craigyjp/Dual-VCDCO-monosynth/Schematics/Control_circuits.pdf

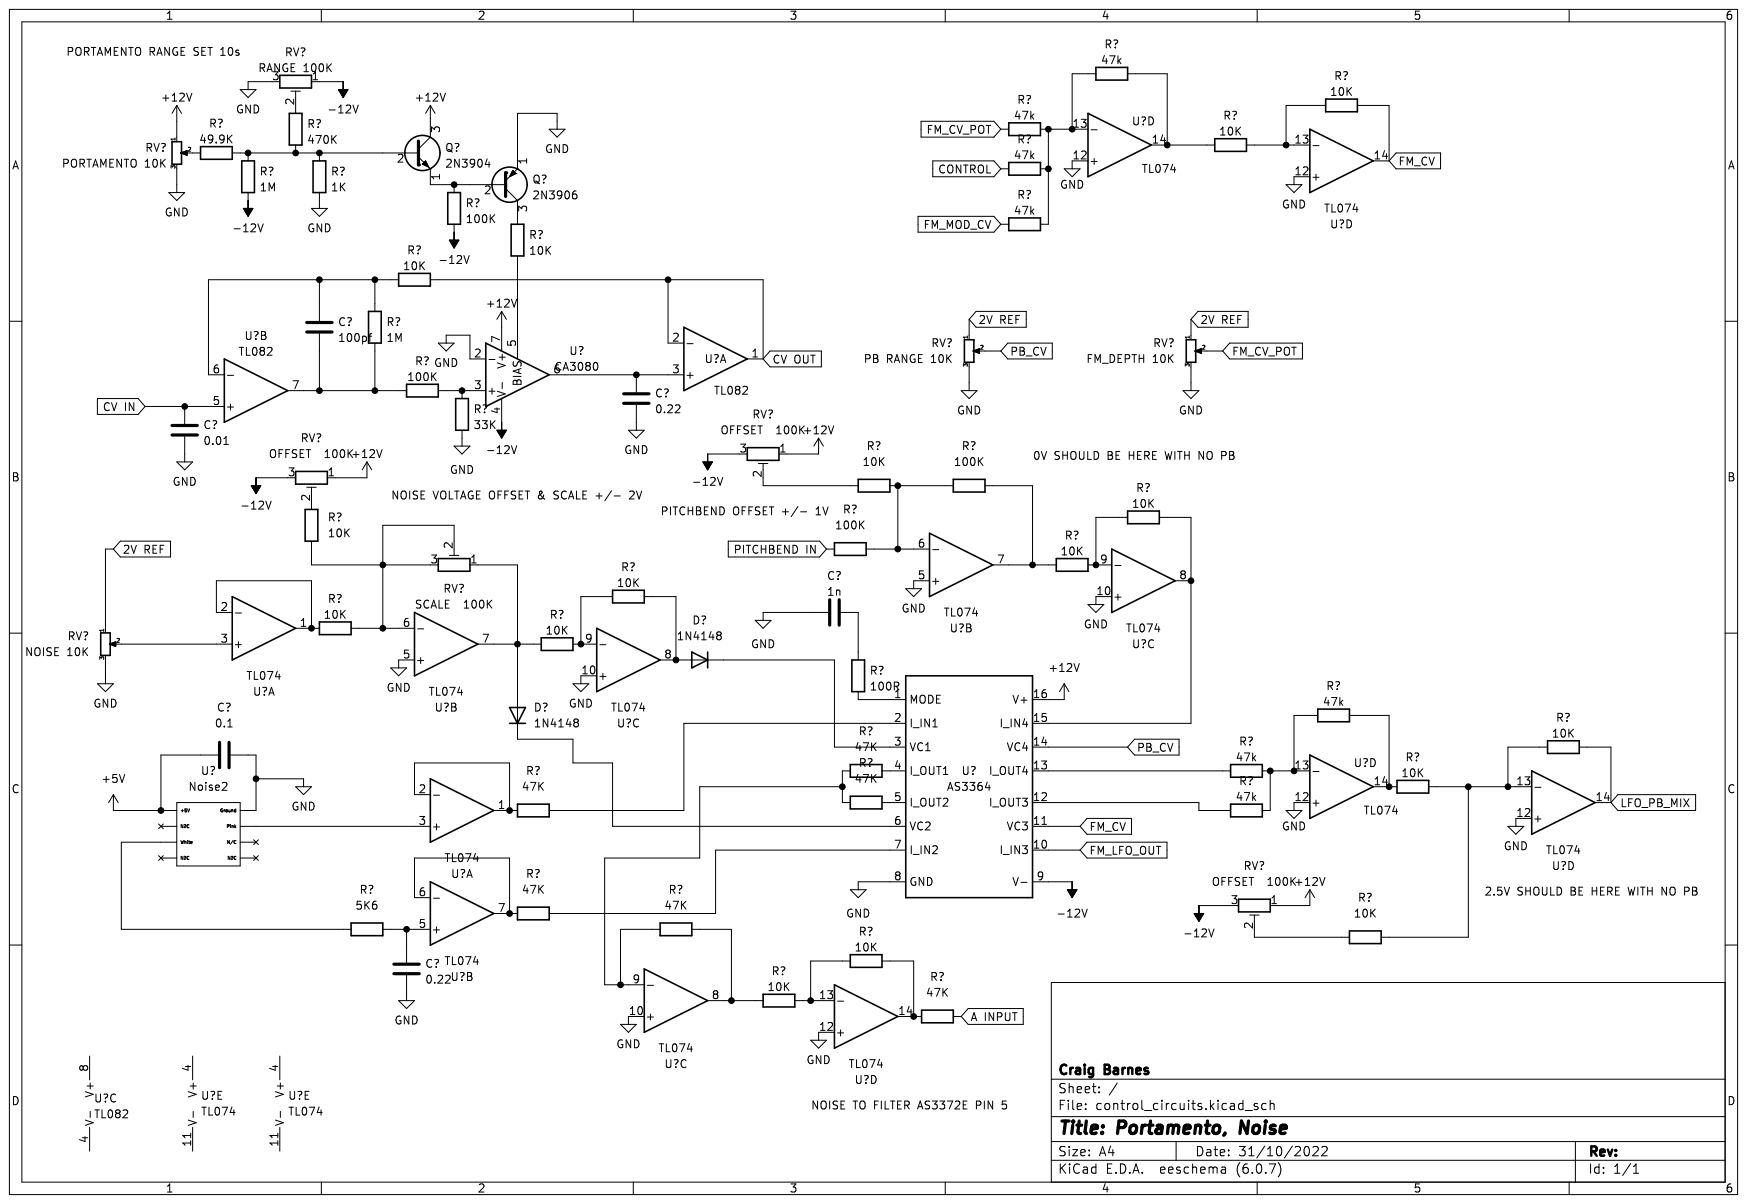
[picture p1: page 1]
