craigyjp/Dual-VCDCO-monosynth/Schematics/EnvGen8C.pdf

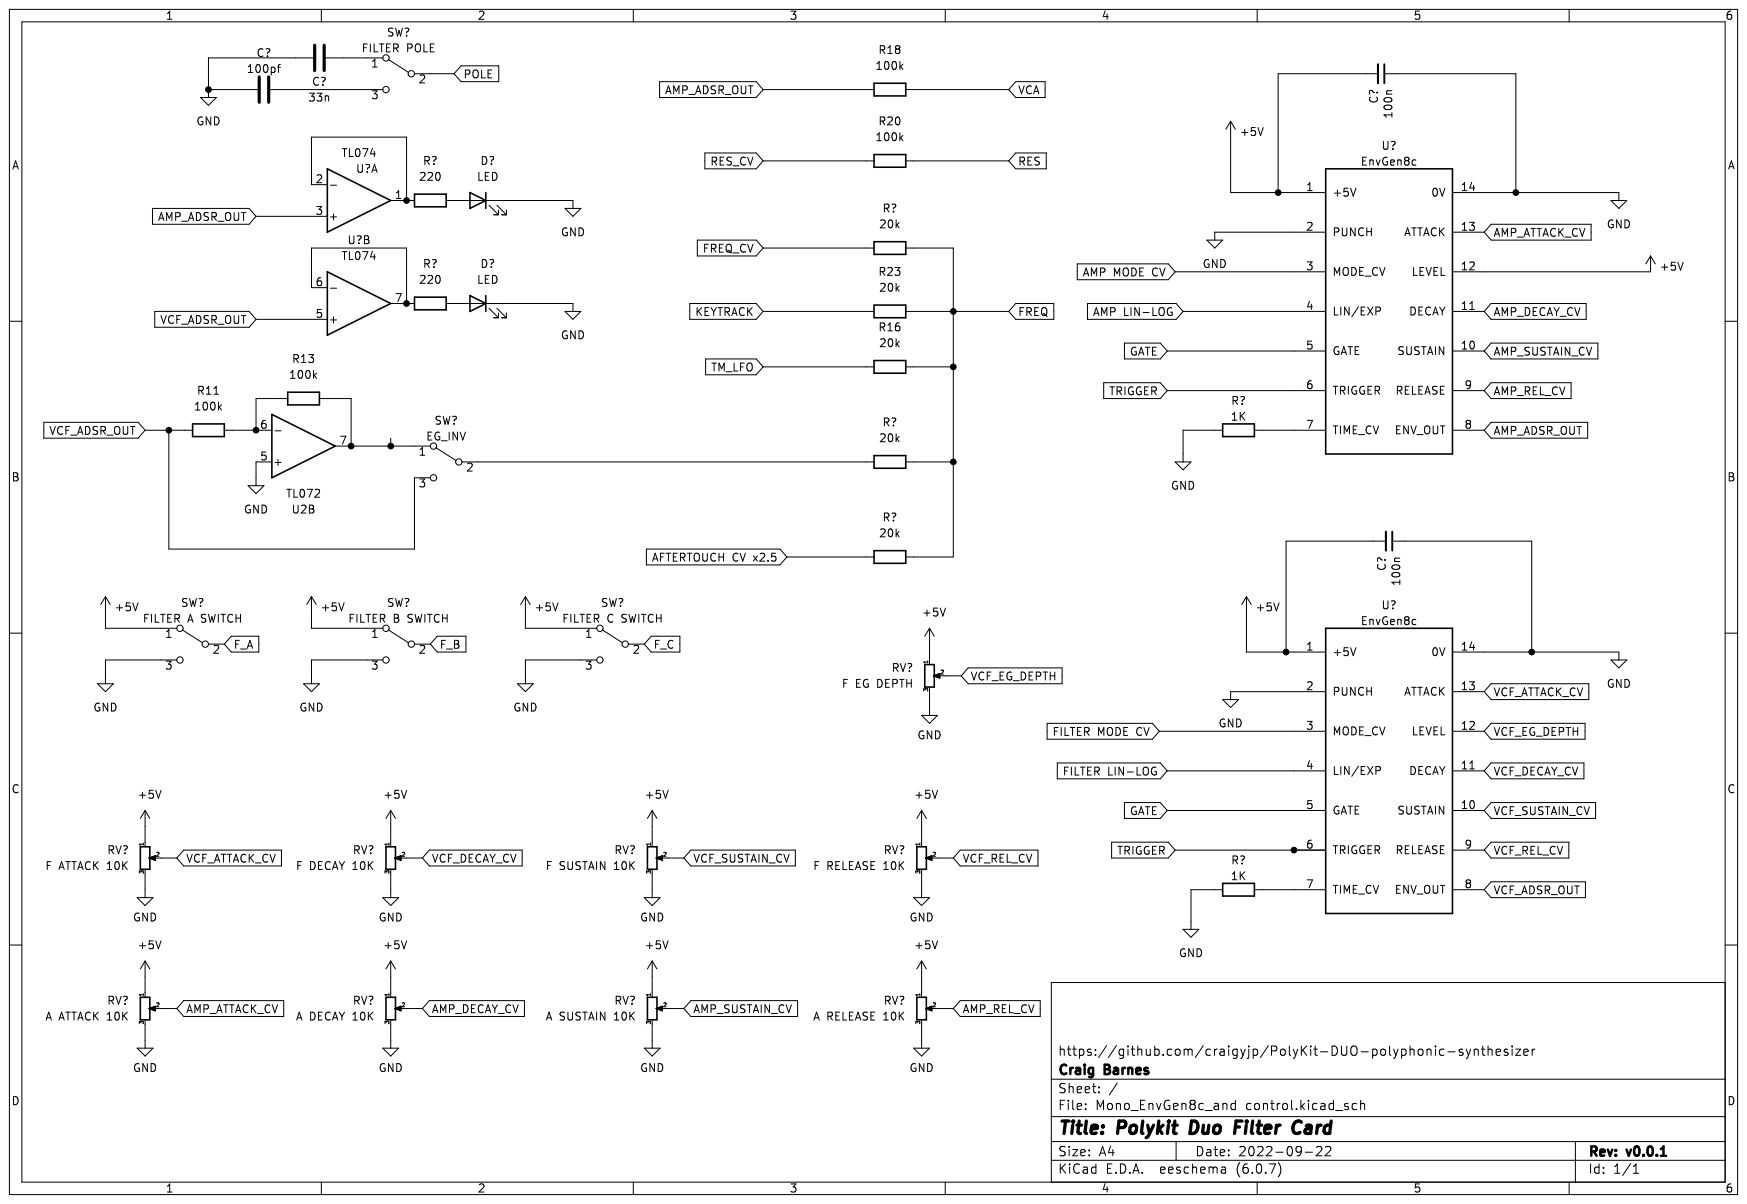
[picture p2: page 1]
