craigyjp/Dual-VCDCO-monosynth/Schematics/MIDI_to_CV_Channel_change.pdf

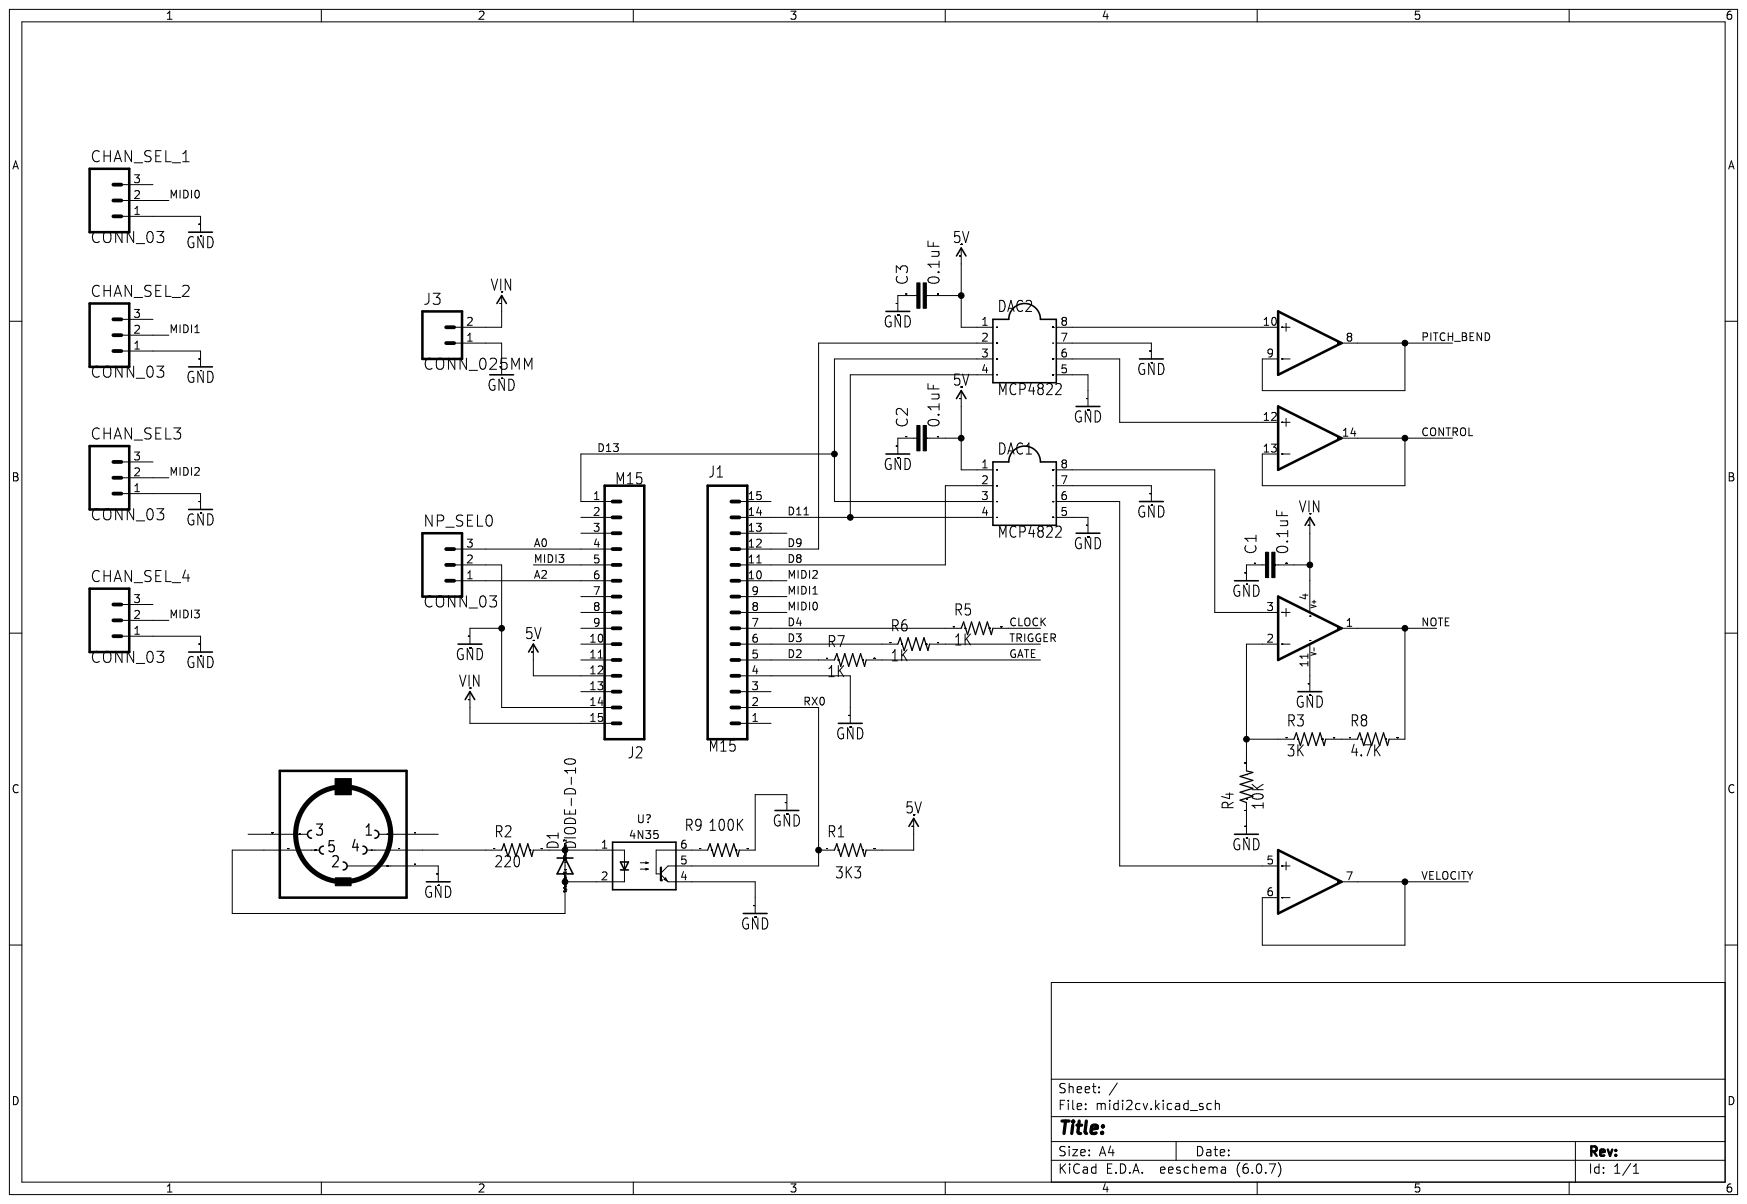
[picture p3: page 1]
