craigyjp/Dual-VCDCO-monosynth/Schematics/VCDCO_Section.pdf

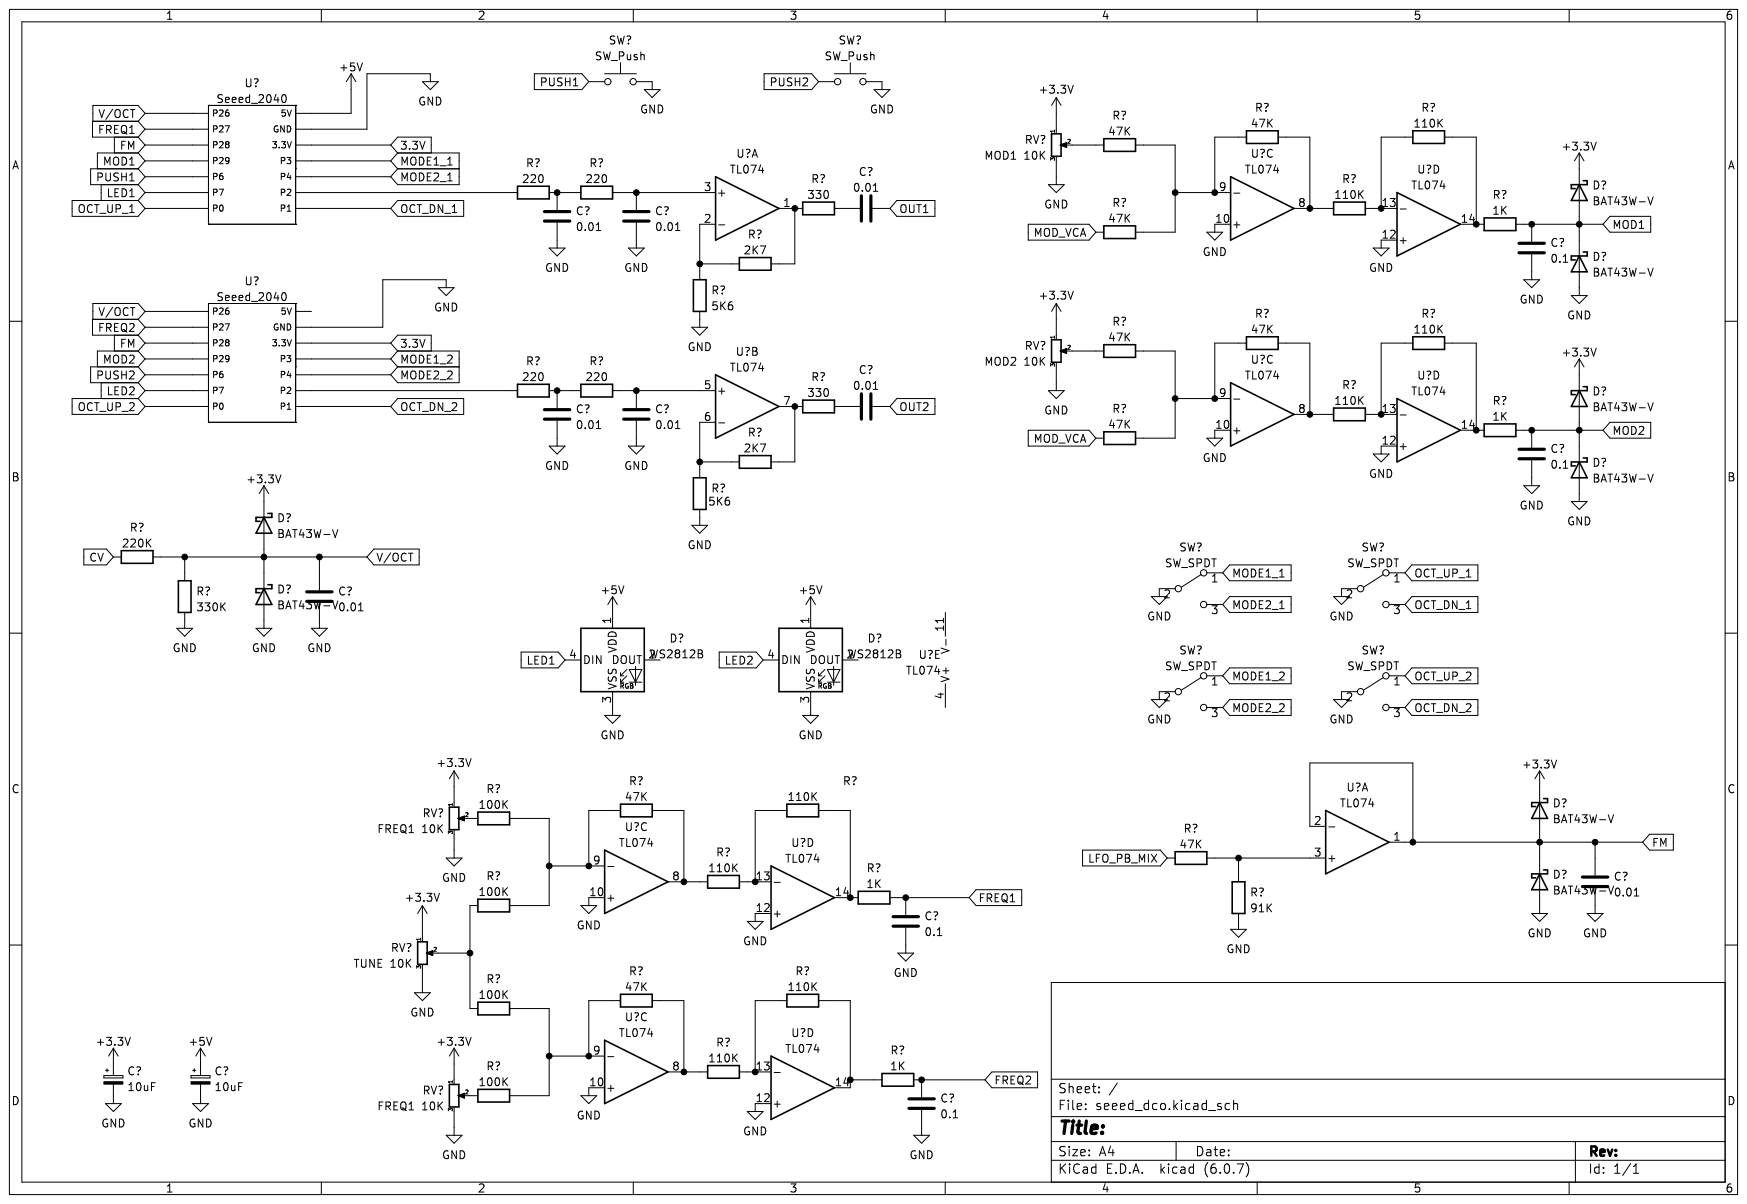
[picture p4: page 1]
