craigyjp/Dual-VCDCO-monosynth/Schematics/LFO_Final_VCA.pdf

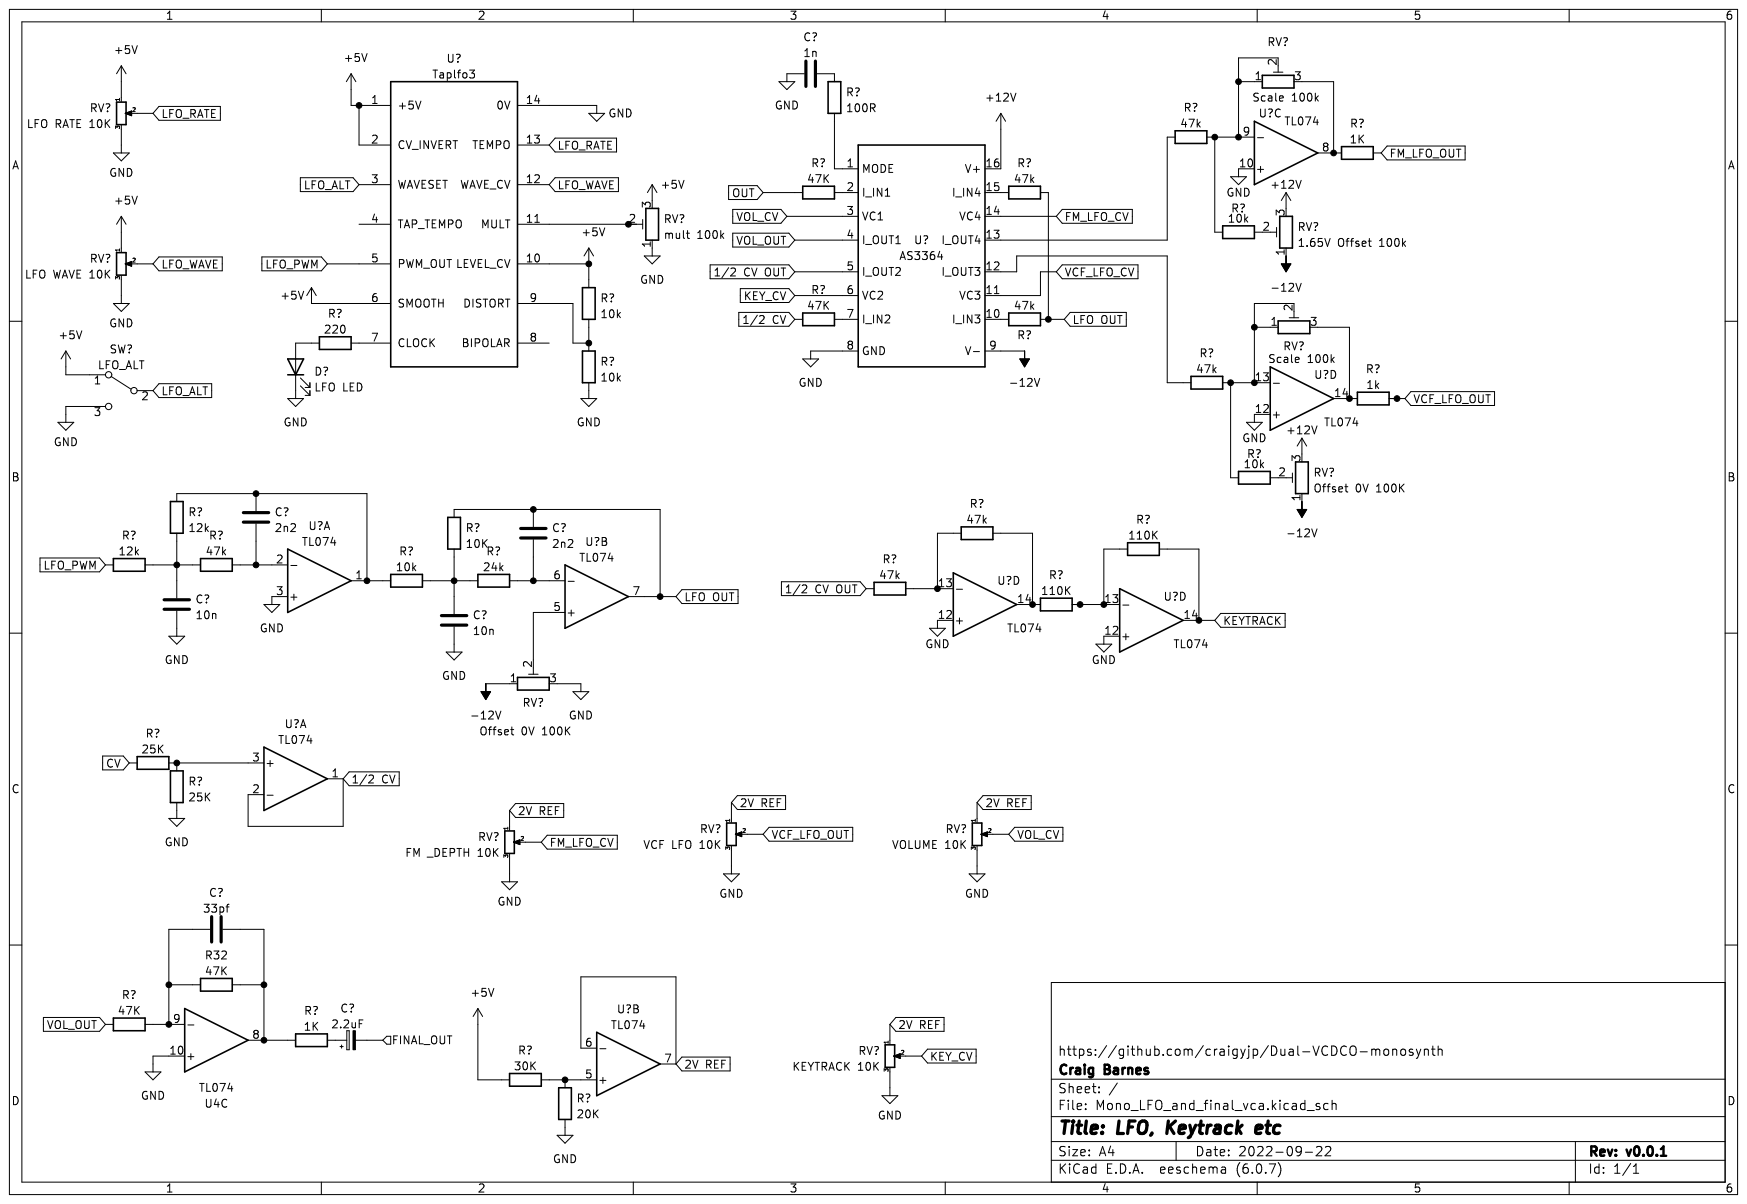
[picture p5: page 1]
