craigyjp/Dual-VCDCO-monosynth/seed_vco_fm_led_pwm.ino

//
// removing wave mod in favour of FM
//

#include <hardware/pwm.h>
#include <Adafruit_NeoPixel.h>

int k = 1;
float AM_mod = 1;//AM modulation rate
float f = 0;
int slice_num = 0;
float osc_freq = 0;
bool push_sw, old_push_sw;//push sw
float mod = 0;
int wavetable[256];//1024 resolution , 256 rate
float mod_wavetable[256];//1st modulated wavetable
int mod2_wavetable[256];//2nd modulated wavetable
float calb = 1.142; //calibration for reduce resistance error
int  adc, freq_pot, fm_input, oct_sw, mode;
int waveform = 0;
//int f0 = 35;//base osc frequency
int f0 = 44;//base osc frequency
long timer = 0;//use for making AM sinewave

const static float voctpow[1230] = {//Covers 6(=1230) octaves. If it is 1230 or more, the operation becomes unstable.
  0,  0.004882, 0.009765, 0.014648, 0.019531, 0.024414, 0.029296, 0.034179, 0.039062, 0.043945, 0.048828, 0.05371,  0.058593, 0.063476, 0.068359, 0.073242, 0.078125, 0.083007, 0.08789,  0.092773, 0.097656, 0.102539, 0.107421, 0.112304, 0.117187, 0.12207,  0.126953, 0.131835, 0.136718, 0.141601, 0.146484, 0.151367, 0.15625,  0.161132, 0.166015, 0.170898, 0.175781, 0.180664, 0.185546, 0.190429, 0.195312, 0.200195, 0.205078, 0.20996,  0.214843, 0.219726, 0.224609, 0.229492, 0.234375, 0.239257, 0.24414,  0.249023, 0.253906, 0.258789, 0.263671, 0.268554, 0.273437, 0.27832,  0.283203, 0.288085, 0.292968, 0.297851, 0.302734, 0.307617, 0.3125, 0.317382, 0.322265, 0.327148, 0.332031, 0.336914, 0.341796, 0.346679, 0.351562, 0.356445, 0.361328, 0.36621,  0.371093, 0.375976, 0.380859, 0.385742, 0.390625, 0.395507, 0.40039,  0.405273, 0.410156, 0.415039, 0.419921, 0.424804, 0.429687, 0.43457,  0.439453, 0.444335, 0.449218, 0.454101, 0.458984, 0.463867, 0.46875,  0.473632, 0.478515, 0.483398, 0.488281, 0.493164, 0.498046, 0.502929, 0.507812, 0.512695, 0.517578, 0.52246,  0.527343, 0.532226, 0.537109, 0.541992, 0.546875, 0.551757, 0.55664,  0.561523, 0.566406, 0.571289, 0.576171, 0.581054, 0.585937, 0.59082,  0.595703, 0.600585, 0.605468, 0.610351, 0.615234, 0.620117, 0.625,  0.629882, 0.634765, 0.639648, 0.644531, 0.649414, 0.654296, 0.659179, 0.664062, 0.668945, 0.673828, 0.67871,  0.683593, 0.688476, 0.693359, 0.698242, 0.703125, 0.708007, 0.71289,  0.717773, 0.722656, 0.727539, 0.732421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
5.883789, 5.888671, 5.893554, 5.898437, 5.90332,  5.908203, 5.913085, 5.917968, 5.922851, 5.927734, 5.932617, 5.9375, 5.942382, 5.947265, 5.952148, 5.957031, 5.961914, 5.966796, 5.971679, 5.976562, 5.981445, 5.986328, 5.99121,  5.996093, 6.000976,
};
float freq_table[2048];

Adafruit_NeoPixel pixel(1, 7, NEO_GRB + NEO_KHZ800);
int colour[][3] = { {100,   0,   0}, // red
  { 88,  12,   0}, // orange
  { 65,  35,   0}, // yellow
  {  0, 100,   0}, // green
  {  0,  70,  20}, // cyan
  {  0,   0, 100}, // blue
  { 40,   0,  40}, // magenta
  { 45,  40,  35}  // white
};

void setup1() {
}

void setup()
{
  pinMode(0, INPUT_PULLUP);//oct select
  pinMode(1, INPUT_PULLUP);//oct select
  pinMode(6, INPUT_PULLUP);//push sw
  pinMode(3, INPUT_PULLUP);//mode select
  pinMode(4, INPUT_PULLUP);//mode select
  timer = micros();

  table_set();//set wavetable
  //-------------------octave select-------------------------------
  for (int i = 0; i < 1230; i++) {//Covers 6(=1230) octaves. If it is 1230 or more, the operation becomes unstable.
    freq_table[i] = f0 * pow(2, (voctpow[i]));
  }
  for (int i = 0; i < 2048 - 1230; i++) {
    freq_table[i + 1230] = 6;
  }

  //-------------------PWM setting-------------------------------
  gpio_set_function(2, GPIO_FUNC_PWM);// set GP2 function PWM
  slice_num = pwm_gpio_to_slice_num(2);// GP2 PWM slice

  pwm_clear_irq(slice_num);
  pwm_set_irq_enabled(slice_num, true);
  irq_set_exclusive_handler(PWM_IRQ_WRAP, on_pwm_wrap);
  irq_set_enabled(PWM_IRQ_WRAP, true);

  //set PWM frequency
  pwm_set_clkdiv(slice_num, 1);//=sysclock/((resolution+1)*frequency)
  pwm_set_wrap(slice_num, 1023);//resolutio
  pwm_set_enabled(slice_num, true);//PWM output enable

  pixel.begin();
  pixel.setPixelColor(0, pixel.Color(colour[0][0], colour[0][1], colour[0][2]));
  pixel.show();

}

void  on_pwm_wrap() {
  pwm_clear_irq(slice_num);
  f = f + osc_freq;
  if (f > 255) {
    f = 0;
  }
  int k = (int)f;
  pwm_set_chan_level(slice_num, PWM_CHAN_A, mod2_wavetable[k] + 511);
}

void loop()
{
  old_push_sw = push_sw;

  //-------------------octave select-------------------------------
  if (digitalRead(0) == 1 && digitalRead(1) == 1) {
    oct_sw = 1;
  }
  else if (digitalRead(0) == 0 && digitalRead(1) == 1) {
    oct_sw = 3;
  }
  else if (digitalRead(0) == 1 && digitalRead(1) == 0) {
    oct_sw = 0;
  }

  //  -------------------mode select-------------------------------
  if (digitalRead(4) == 1 && digitalRead(3) == 1) {
    mode = 1;//fm
  }
  else if (digitalRead(4) == 0 && digitalRead(3) == 1) {
    mode = 0;//AM
  }
  else if (digitalRead(4) == 1 && digitalRead(3) == 0) {
    mode = 2;//wavefolder
  }

  //  -------------------frequeny calculation-------------------------------
  adc = analogRead(26) * calb;//Correct resistance errors
  adc = constrain(adc , 0, 1225) ;//Covers 6(=1220) octaves. If it is 1230 or more, the operation becomes unstable.
  freq_pot = map(analogRead(27), 0, 1023, 0, 127);
  fm_input = map(analogRead(28), 0, 1023, 0, 63);
  fm_input = fm_input - (1 << 5);
  //Serial.println(fm_input);
  osc_freq = freq_table[adc + freq_pot]; // V/oct apply
  //osc_freq = 256 * (osc_freq) / 122070 * (1 + oct_sw);
  osc_freq = 256 * (osc_freq + fm_input) / 122070 * (1 + oct_sw);

  //  -------------------mod parameter set-------------------------------
  if (mode == 0) {//fold
    if (2 != waveform) { // normal wavefold
      mod = constrain(analogRead(29), 0, 1023) * 0.0036 + 0.90; //28 is CV , 29 is pot
    } else {  // PWM for square wave
      mod = constrain(analogRead(29), 0, 1023) / 8;
    }
  }
  else if (mode == 1) {//FM
    mod = constrain(analogRead(29), 0, 1023) / 8;
  }
  else if (mode == 2) {//AM
    mod = 1023 - constrain(analogRead(29), 0, 1023) ;
  }

  //  -------------------push sw-------------------------------
  push_sw = digitalRead(6);
  if (push_sw == 0 && old_push_sw == 1) {//when push sw ON
    waveform++;//change waveform
    if (waveform > 7) {
      waveform = 0;
    }
    if (mode == 0 || mode == 2) {
      table_set();
    }
    // set the neopixel colour
    pixel.clear();
    pixel.setPixelColor(0, pixel.Color(colour[waveform][0], colour[waveform][1], colour[waveform][2]));
    pixel.show();
  }
  //}

  //void loop1() {//modulation
  if (mode == 0) { // wavefold
    if (2 == waveform) {
      // PWM rather than wavefolding for square wave
      for (int i = 0; i < 128 + mod; i++) {
        mod2_wavetable[i] = 511;
      }
      for (int i = 128 + mod; i < 256; i++) {
        mod2_wavetable[i] = -511;
      }
    } else {
      for (int i = 0; i < 256; i++) {
        mod_wavetable[i] = wavetable[i] * mod;
      }
      for (int i = 0; i < 256; i++) {
        if (mod_wavetable[i] > 511 && mod_wavetable[i] < 1023 + 512) {
          mod2_wavetable[i] = 1024 - mod_wavetable[i];
        }
        else if (mod_wavetable[i] < -512 && mod_wavetable[i] > -1024 - 512) {
          mod2_wavetable[i] = -1023 - mod_wavetable[i];
        }
        else if (mod_wavetable[i] < -1024 - 511) {
          mod2_wavetable[i] = 2048 + mod_wavetable[i];
        }
        else if (mod_wavetable[i] > 1023 + 511) {
          mod2_wavetable[i] = -2047 + mod_wavetable[i];
        }
        else {
          mod2_wavetable[i] = mod_wavetable[i] ;
        }
      }
    }
  }
  else if (mode == 1) {//FM
    switch  (waveform) {
      case 0:
        for (int i = 0; i < 256; i++) {  //FM1
          mod2_wavetable[i] = (sin(2 * M_PI * i  / 256 + mod / 128 * sin(2 * M_PI * 3 * i  / 256)) ) * 511;
        }
        break;

      case 1:
        for (int i = 0; i < 256; i++) {  //FM2
          mod2_wavetable[i] = (sin(2 * M_PI * i  / 256 + mod / 128 * sin(2 * M_PI * 3 * i  / 256 + mod / 128 * sin(2 * M_PI * 3 * i  / 256))) ) * 511;
        }
        break;

      case 2:
        for (int i = 0; i < 256; i++) {  //FM3
          mod2_wavetable[i] = (sin(2 * M_PI * i  / 256 + mod / 128 * sin(2 * M_PI * 5 * i  / 256 + mod / 128 * sin(2 * M_PI * 7 * i  / 256))) ) * 511;
        }
        break;

      case 3:
        for (int i = 0; i < 256; i++) {  //FM4
          mod2_wavetable[i] = (sin(2 * M_PI * i  / 256 + mod / 128 * sin(2 * M_PI * 9 * i  / 256 + mod / 128 * sin(2 * M_PI * 5 * i  / 256))) ) * 511;
        }
        break;

      case 4:
        for (int i = 0; i < 256; i++) {  //FM5
          mod2_wavetable[i] = ((sin(2 * M_PI * i  / 256 + mod / 128 * sin(2 * M_PI * 19 * i  / 256)) ) + (sin(2 * M_PI * 3 * i  / 256 + mod / 128 * sin(2 * M_PI * 7 * i  / 256)) )) / 2 * 511;
        }
        break;

      case 5:
        for (int i = 0; i < 256; i++) {  //FM6
          mod2_wavetable[i] = ((sin(2 * M_PI * i  / 256 + mod / 128 * sin(2 * M_PI * 7 * i  / 124)) ) + (sin(2 * M_PI * 9 * i  / 368 + mod / 128 * sin(2 * M_PI * 11 * i  / 256)) )) * 511;
        }
        break;

      case 6:
        for (int i = 0; i < 256; i++) {  //FM7
          mod2_wavetable[i] = ((sin(2 * M_PI * i  / 256 + mod / 128 * sin(2 * M_PI * 13 * i  / 256)) ) + (sin(2 * M_PI * 17 * i  / 111 + mod / 128 * sin(2 * M_PI * 19 * i  / 89)) )) * 511;
        }
        break;

      case 7:
        for (int i = 0; i < 256; i++) {  //FM8
          mod2_wavetable[i] = (sin(2 * M_PI * i  / 256 + mod / 128 * sin(2 * M_PI * 11 * i  / 124 + mod / 128 * sin(2 * M_PI * 7 * i  / 333 + mod / 128 * sin(2 * M_PI * 9 * i  / 56)))) )  * 511;
        }
        break;
    }
  }

  else if (mode == 2) {//AM
    if (timer + mod <= micros()) {
      k++;
      if (k > 63) {
        k = 0;
      }
      AM_mod = sin( 2 * M_PI * k  / 63);//make modulation sine wave
      for (int i = 0; i < 255 ; i++) {
        mod2_wavetable[i] = wavetable[i] * AM_mod;//multiply AM sine wave
      }
      timer = micros();
    }
  }

}

void table_set() {//make wavetable

  if (mode == 0) { //wavefold
    switch  (waveform) {
      case 0:
        for (int i = 0; i < 256; i++) {  //saw
          wavetable[i] = i * 4 - 512;
        }
        break;

      case 1:
        for (int i = 0; i < 256; i++) {  //sin
          wavetable[i] = (sin(2 * M_PI * i  / 256)) * 511;
        }
        break;

      case 2:
        for (int i = 0; i < 128; i++) {  //squ
          wavetable[i] = 511;
          wavetable[i + 128] = -511;
        }
        break;

      case 3:
        for (int i = 0; i < 128; i++) {  //tri
          wavetable[i] = i * 8 - 511;
          wavetable[i + 128] = 511 - i * 8;
        }
        break;

      case 4:
        for (int i = 0; i < 128; i++) {  //oct saw
          wavetable[i] = i * 4 - 512 + i * 2;
          wavetable[i + 128] = i * 2 - 256 + i * 4;
        }
        break;

      case 5:
        for (int i = 0; i < 256; i++) {  //FM1
          wavetable[i] = (sin(2 * M_PI * i  / 256 + sin(2 * M_PI * 3 * i  / 256)) ) * 511;
        }
        break;

      case 6:
        for (int i = 0; i < 256; i++) {  //FM2
          wavetable[i] = (sin(2 * M_PI * i  / 256 + sin(2 * M_PI * 7 * i  / 256))) * 511;
        }
        break;

      case 7:
        for (int i = 0; i < 256; i++) {  //FM3
          wavetable[i] = (sin(2 * M_PI * i  / 256 + sin(2 * M_PI * 4 * i  / 256 + sin(2 * M_PI * 11 * i  / 256)))) * 511;
        }
        break;
    }
  }
  else if (mode == 2) { //AM
    switch  (waveform) {
      case 0:
        for (int i = 0; i < 256; i++) {  //saw
          wavetable[i] = (sin(2 * M_PI * i  / 256)) * 511;
        }
        break;

      case 1:
        for (int i = 0; i < 256; i++) {  //fm1
          wavetable[i] = (sin(2 * M_PI * i  / 256 + sin(2 * M_PI * 3 * i  / 256)) ) * 511;
        }
        break;

      case 2:
        for (int i = 0; i < 256; i++) {  //fm2
          wavetable[i] = (sin(2 * M_PI * i  / 256 + sin(2 * M_PI * 5 * i  / 256)) ) * 511;
        }
        break;

      case 3:
        for (int i = 0; i < 256; i++) {  //fm3
          wavetable[i] = (sin(2 * M_PI * i  / 256 + sin(2 * M_PI * 4 * i  / 256 + sin(2 * M_PI * 11 * i  / 256)))) * 511;
        }
        break;

      case 4:
        for (int i = 0; i < 256; i++) {  //non-integer multiplets fm1
          wavetable[i] = (sin(2 * M_PI * i  / 256 + sin(2 * M_PI * 1.28 * i  / 256)) ) * 511;
        }
        break;

      case 5:
        for (int i = 0; i < 256; i++) {  //non-integer multiplets fm2
          wavetable[i] = (sin(2 * M_PI * i  / 256 + sin(2 * M_PI * 3.19 * i  / 256)) ) * 511;
        }
        break;

      case 6:
        for (int i = 0; i < 256; i++) {  //non-integer multiplets fm3
          wavetable[i] = (sin(2 * M_PI * i  / 256 + sin(2 * M_PI * 2.3 * i  / 256 + sin(2 * M_PI * 7.3 * i  / 256)))) * 511;
        }
        break;

      case 7:
        for (int i = 0; i < 256; i++) {  //non-integer multiplets fm3
          wavetable[i] = (sin(2 * M_PI * i  / 256 + sin(2 * M_PI * 6.3 * i  / 256 + sin(2 * M_PI * 11.3 * i  / 256)))) * 511;
        }
        break;
    }
  }
}
