craigyjp/Dual-VCDCO-monosynth/(commit log)

2022-10-25 Added the DCO schematics
2022-10-28 Added the FM input, Wave NeoPixel LED and PWM
2022-10-31 Added Noise schematics to the control section
2022-10-31 Added voltage ref for VCA control
2022-10-31 Fixed PB voltage levels
2022-11-04 Added new MIDI to CV with aftertouch
    Removed the velocity and added aftertouch, maybe in the future if I can get anoth MCP4822 I can add both.
