craigyjp/Dual-VCDCO-monosynth/(notices)

Notices in the files:
Elkyam_MIDI_CV_After-no-velocity.ino:
This program is free software: you can redistribute it and/or modify
it under the terms of the GNU General Public License as published by
the Free Software Foundation, either version 3 of the License, or
(at your option) any later version.
